Saad-Mechtro/Multi-Stage-Analog-Conductive-Medium-Monitoring-System/Multi-Stage-Analog-Conductive-Medium-Monitoring-System/Images/real 2.png

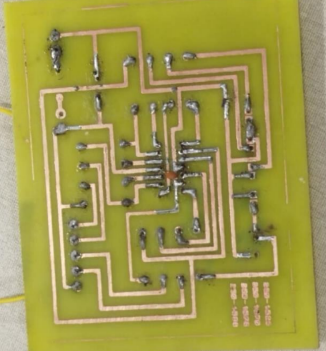
Multi-Stage-Analog-Conductive-Medium-Monitoring-System/Images/real 2.png
