Saad-Mechtro/Multi-Stage-Analog-Conductive-Medium-Monitoring-System/Multi-Stage-Analog-Conductive-Medium-Monitoring-System/Images/3D.png

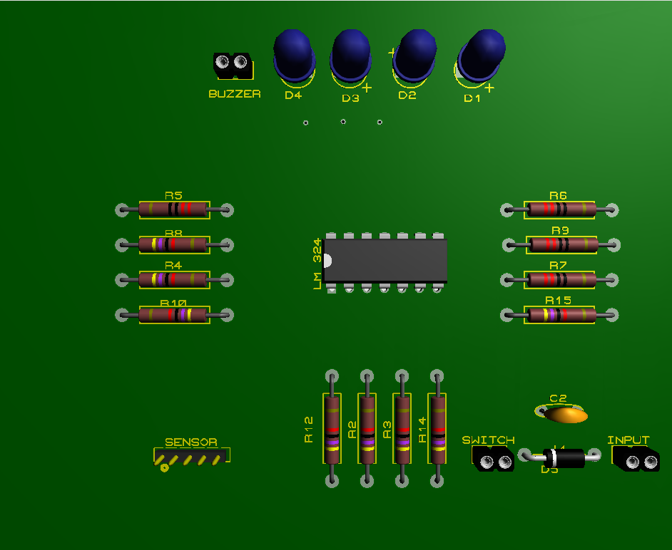
Multi-Stage-Analog-Conductive-Medium-Monitoring-System/Images/3D.png
