Saad-Mechtro/Multi-Stage-Analog-Conductive-Medium-Monitoring-System/Multi-Stage-Analog-Conductive-Medium-Monitoring-System/Images/real pcb.png

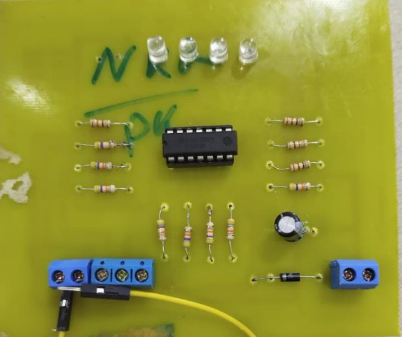
Multi-Stage-Analog-Conductive-Medium-Monitoring-System/Images/real pcb.png
