Saad-Mechtro/Multi-Stage-Analog-Conductive-Medium-Monitoring-System/Multi-Stage-Analog-Conductive-Medium-Monitoring-System/Images/schematics.png

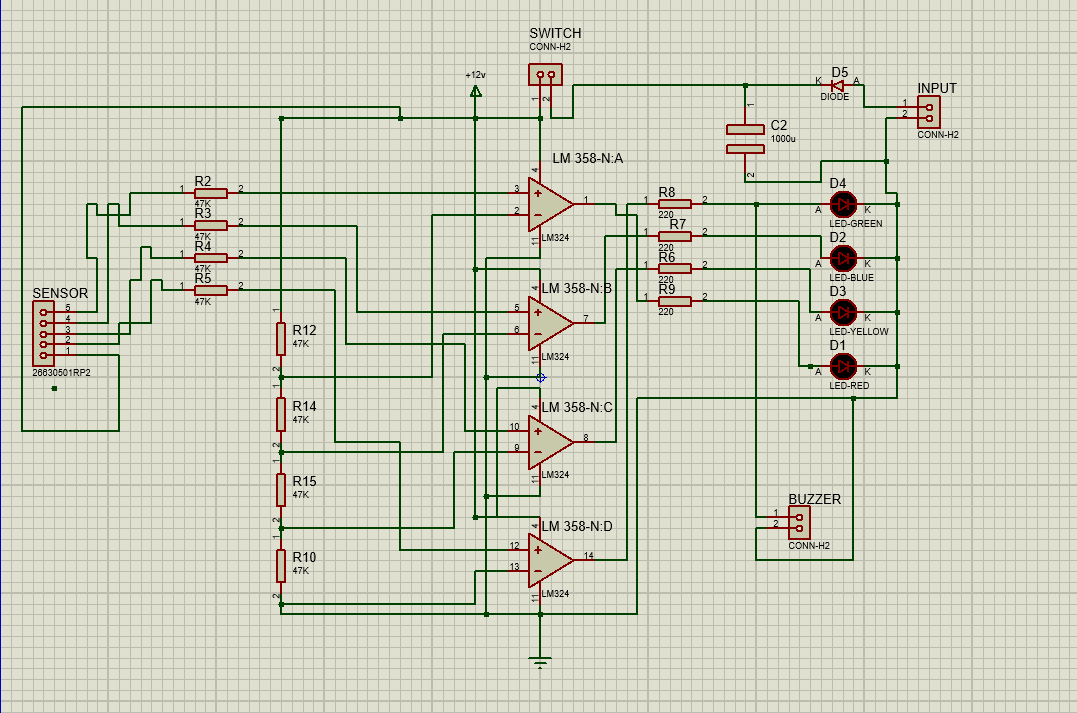
Multi-Stage-Analog-Conductive-Medium-Monitoring-System/Images/schematics.png
