Saad-Mechtro/Multi-Stage-Analog-Conductive-Medium-Monitoring-System/(list of files, drawings)

Other design files:
Multi-Stage-Analog-Conductive-Medium-Monitoring-System/Proteus Files/PCB Final ( with small resistors ).pdsprj
